GitRE41187/PCB/Export/MyPCB_BOM.csv

Comment | Designator | Footprint | Quantity | LCSC Part # | Manufacturer
AMS1117-3.3 | U1 | SOT-223-3_L6.5-W3.4-P2.30-LS7.0-BR | 1 | C6186 | Advanced Monolithic Systems
PCF8574P | U2 | DIP-16_L19.3-W6.4-P2.54-LS7.6-BL | 1 | C398073 | HGSEMI
74HC595N | U3 | DIP-16_L19.8-W6.5-P2.54-LS7.6-BL | 1 | C669328 | HTC
MCP3208-CI/P | U4 | PDIP-16_L19.2-W6.6-P2.54-LS7.62-BL | 1 | C1543277 | Microchip
HS1602A-B (LCD1602) | LCD1 | LCD1602 | 1 | C18198249 | HS
10uF | C1, C2, C5 | CAP-TH_BD5.0-P2.50-D1.0-FD | 3 | C1580515 | Nichicon
100nF | C3, C4, C6 | CAP-TH_L6.0-W6.0-P2.54-D1.0 | 3 | C353909 | Dersonic
10k | R2, R3, R4, R5, R6 | RES-TH_BD2.4-L6.3-P10.30-D0.6 | 5 | C5618323 | YAGEO
330R | R7, R8, R9, R10, R11, R12, R13, R14, R15, R16, R17, R18 | RES-TH_BD2.4-L6.3-P10.30-D0.6 | 12 | C2935230 | YAGEO
10k Trimpot 3386P | RV1 | RES-ADJ-TH_3P-L9.5-W9.5-P2.54-BR-BS | 1 | C116281 | BOURNS
LED 3mm Red | LED1, LED2, LED3, LED4, LED5, LED6, LED7, LED8, LED9, LED10, LED11, LED12 | LED-TH_BD3.0-P2.54-FD | 12
TS1212TPFS 250gf (Tactile SW 12x12) | SW1, SW2, SW3, SW4, SW5, SW6 | KEY-SMD_4P-L12.0-W12.0-P5.00-LS15.0 | 6 | C2858285 | SHOU HAN
Pin header 1x2 male | H1, H4, H7 | HDR-TH_2P-P2.54-V-M | 3 | C492401 | XFCN
Pin header 1x3 male | H2, H5, H8 | HDR-TH_3P-P2.54-V-M_PZ254V-11-03P | 3 | C2937625 | XFCN
Pin header 1x4 male | H12, H13 | HDR-TH_4P-P2.54-V-M | 2 | C2691448 | XFCN
Pin header 1x6 male | H3 | HDR-TH_6P-P2.54-V-M | 1 | C492405 | XFCN
Pin header 1x8 male | H6, H9, H10 | HDR-TH_8P-P2.54-V-M | 3 | C492407 | XFCN
Pin header 1x16 male | H11 | HDR-TH_PZ254V-11-16P | 1 | C22465876 | XFCN
Pin header 1x19 male | H14, H15 | HDR-TH_19P-P2.54-V-M | 2 | C22465879 | XFCN
Female header 1x4 | J3, J4 | HDR-TH_4P-P2.54-V-F | 2 | C3012026 | HCTL
Female header 1x10 | J5 | HDR-TH_10P-P2.54-V-F | 1 | C2897373 | HCTL
Female header 1x19 (ESP32 socket) | J1, J2 | HDR-TH_19P-P2.54-V-F | 2 | C2897382 | HCTL
