GitRE41187/PCB/Export/MyPCB_Toner_A4.pdf

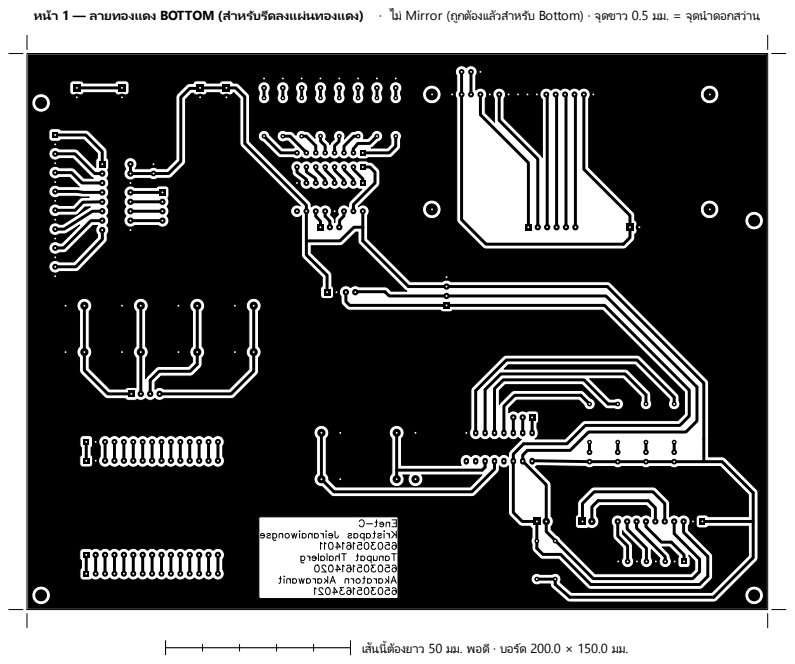
[picture p1: page 1]
หน้า 1 — ลายทองแดง BOTTOM (สำ หรับรั; ลงแผ่นทองแดง) · ไม่ Mirror (ถูกถู; งแล้วล้; Bottom) · จุดขาว 0.5 มม. = จุดนำ ดอกสว่าน; งยาว 50 มม. พอดี · บอร์ดร์

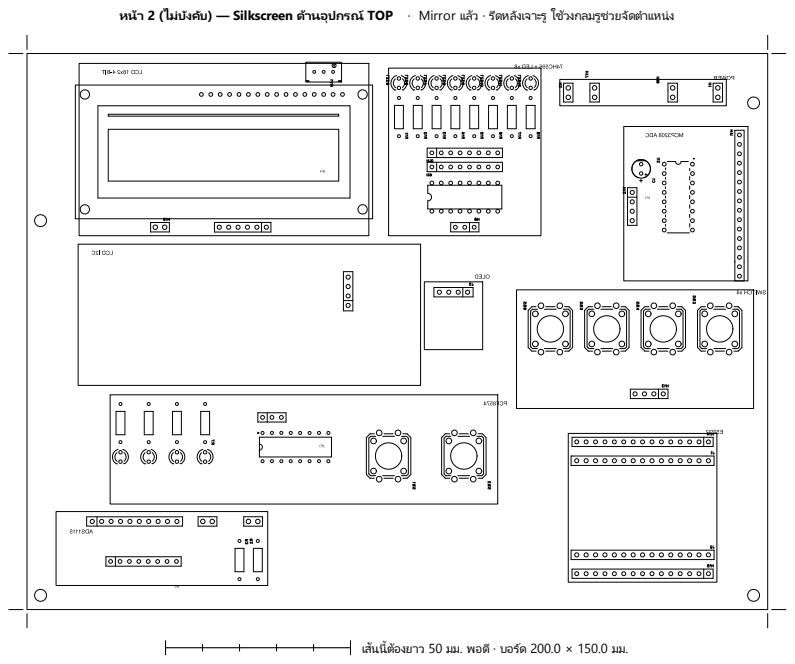
[picture p2: page 2]
) — Silkscreen ด้าด้; นอุปกรณ์ TOP · Mirror แล้วล้; หลังเจาะรู ใช้วช้; งกลมรูช่วยจัดตำ แหน่ง; งยาว 50 มม. พอดี · บอร์ดร์
