GitRE41187/PCB/(commit log)

2026-10-13 Add PCB project backups
    Save dated project snapshots from before artwork, photo layout, schematic PDF, and single-sided reroute changes, plus a project-file backup. Update the active MyPCB project.
2026-10-16 Update PCB project and add backups
    Save the updated project, add four timestamped project backups, and record new application warnings in debug.log.
2026-10-17 Update PCB project and debug log
    Refresh the project file and record the latest PDFium font lookup warning.
2026-11-05 update final + test run
    [MyPCB_BOM.csv]
2026-11-09 Improve LCD diagnostics and I2C scan guidance
    Add an interactive LCD pin-walk test and adjust GPIO timing for better display compatibility. Clarify I2C scan requirements and report detected devices. Update the PCB backup.
